nakhonthai/M17AnalogGateway/image/Alinco_Pinout.png

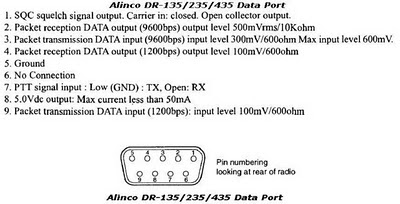
image/Alinco_Pinout.png
