nakhonthai/M17AnalogGateway/image/ESP32DR_Simple_Model.png

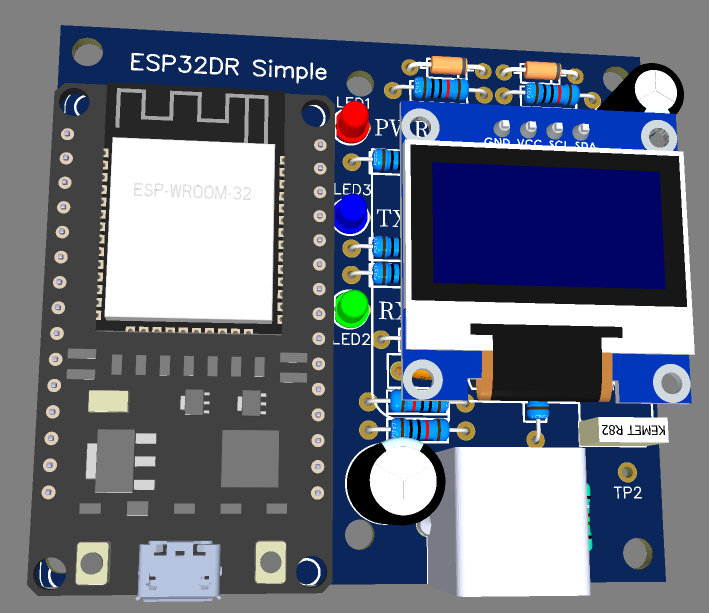
image/ESP32DR_Simple_Model.png
