nakhonthai/M17AnalogGateway/image/PCB_Layout.png

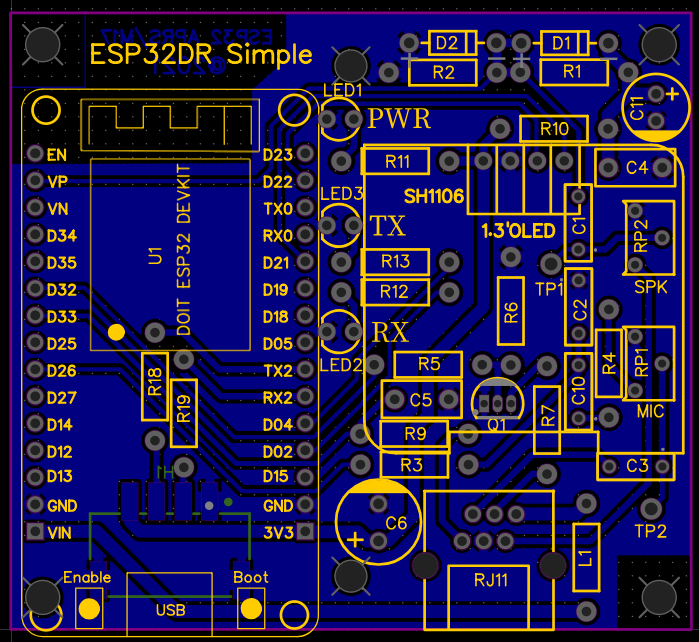
image/PCB_Layout.png
