nakhonthai/M17AnalogGateway/image/RJ12.png

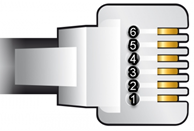
image/RJ12.png
