nakhonthai/M17AnalogGateway/schematic/M17AnalogGw_schematic.png

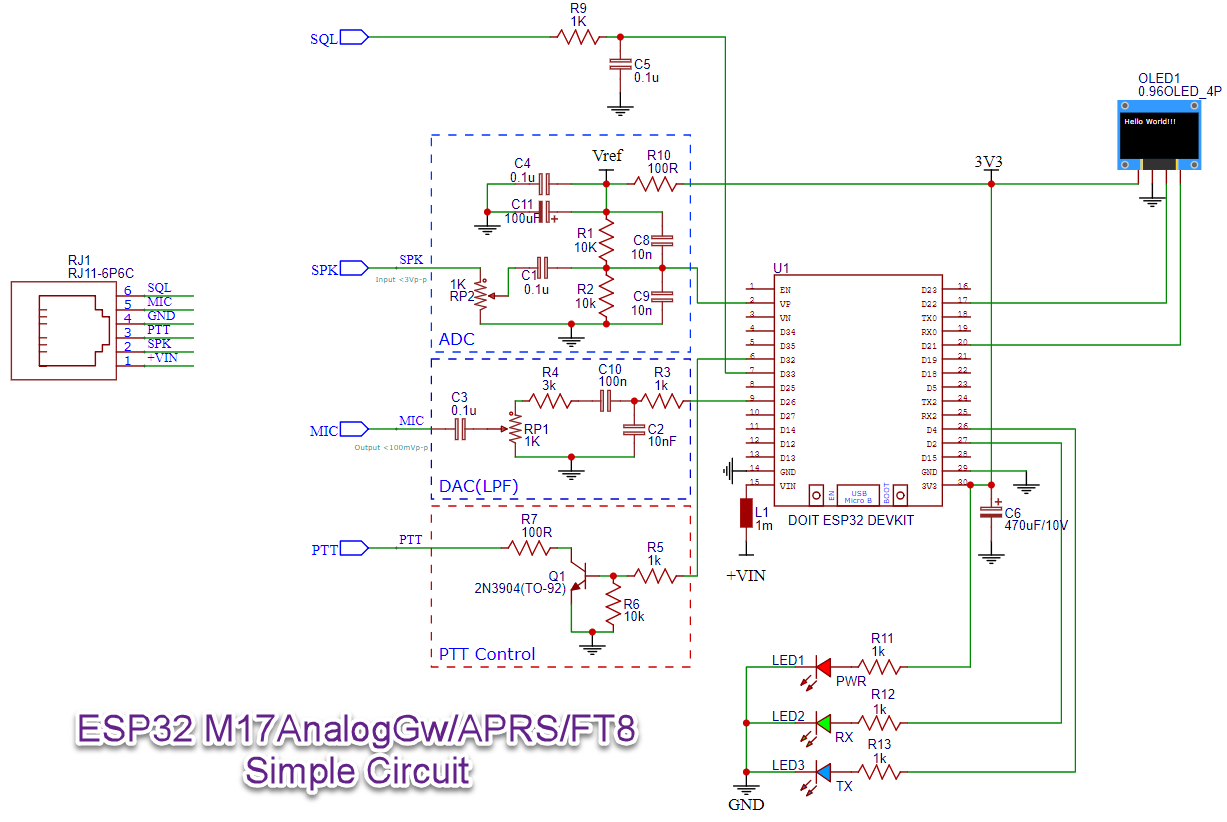
schematic/M17AnalogGw_schematic.png
