nakhonthai/M17AnalogGateway/schematic/M17Hotspot.png

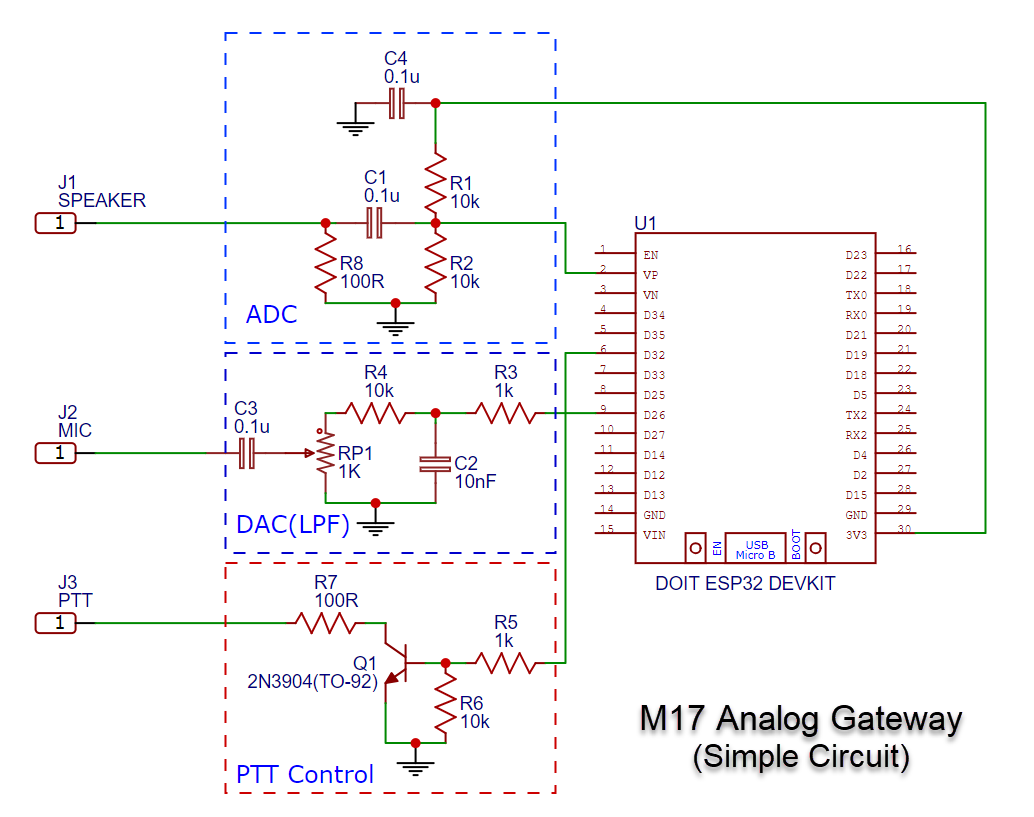
schematic/M17Hotspot.png
