nakhonthai/M17AnalogGateway/(threads)

Thread 5 (2022-03-27):

Add a MEM I2S microphone for the esp32

jumbo5566, 2022-03-27:
i'm trying this SPH0645 MEM microphone
[https://github.com/atomic14/ICS-43434-breakout-board/tree/main/sketch](https://github.com/atomic14/ICS-43434-breakout-board/tree/main/sketch)

nakhonthai, 2022-03-30:
You can connect interface external I2S pinout and change to I2S mode.

Closed 2022-04-05.

Thread 8 (2022-05-11):

Feature request: Analog repeater function

kc1awv, 2022-05-11:
If possible, could the audio path while the ESP32 is receiving also be passed to the TX line with a PTT signal? Basically, operate as an analog repeater, with an analog to digital transcode to an M17 reflector? This could be a simple function with a configuration switch to choose between simplex and duplex.

jumbo5566, 2023-02-19:
YES,the TX LED on just a PTT signal.
on the RF module SRFRS have PTT COS Voice SPK line

Thread 10 (2022-09-23):

Problem with compile version 0.9

sp2ong, 2022-09-23:
Hi,

Can you write which version PlatformIO IDE you are to use in Visual  Studio Code ?

I used latest version PlatformIO IDE v2.5.4 and when I try complied your code form github version 0.9 I have a lot of errors in
code and compile  filed.

src/I2S.cpp:16:14: error: 'RTC_MODULE_TAG' was not declared in this scope
src/I2S.cpp:132:10: error: 'i2s_read_bytes' was not declared in this scope
src/I2S.cpp:137:3: error: 'i2s_write_bytes' was not declared in this scope
src/main.cpp:2285:27: error: cannot convert 'esp_interface_t' to 'wifi_interface_t' in assignment
src/main.cpp:2358:27: error: cannot convert 'esp_interface_t' to 'wifi_interface_t' in assignment
*** [.pio/build/nodemcu-32s/src/I2S.cpp.o] Error 1
*** [.pio/build/nodemcu-32s/src/main.cpp.o] Error 1

sp2ong, 2022-09-23:
When I upload your complied firmware M17AG_ADC_SH1106_V09.bin

rst:0x1 (POWERON_RESET),boot:0x13 (SPI_FAST_FLASH_BOOT)
configsip: 0, SPIWP:0xee
clk_drv:0x00,q_drv:0x00,d_drv:0x00,cs0_drv:0x00,hd_drv:0x00,wp_drv:0x00
mode:DIO, clock div:2
load:0x3fff0018,len:4
load:0x3fff001c,len:1044
load:0x40078000,len:10044
load:0x40080400,len:5900
entry 0x400806ac
v_ref routed to 1.24V

M17 Analog Gateway V0.9
Push BOOT after 3sec for Factory Default config.
Default configure mode!
Default configure!
Create CODEC2_1600 : nsam=320 ,nbit=64 ,nbyte=8
Create CODEC2_3200 : nsam=160 ,nbit=64 ,nbyte=8
Task DSP has been start
Task Network has been start
WiFi Station Only mode.
Current protocol code is 7
Protocol is WIFI_PROTOCOL_11B
Protocol is WIFI_PROTOCOL_11G
Protocol is WIFI_PROTOCOL_11N
WiFi Connecting to APRSTH
..............................Failed. Will retry...

but never I see in my network AP with name "M17AGate" so I can not connect to ESP32

sp2ong, 2022-09-23:
It is look compiled firmware has set up only STATION Mode not have set AP Mode for this reason ESP32 try to connect to APRSTH AP so we need configure own local AP with name APRSTH and passowrd "aprsthnetwork" to allow connect ESP32 and obtain IP adress and after this we can reconfigure ESP32 to own network. It maybe better will be that compiled firmware should be has active AP Mode with name "M17Agate"

jumbo5566, 2023-02-19:
AP mode is don't work, Just Let It RUN Client Mode。

Thread 11 (2023-09-23):

Wi -Fi does not turn on

Guber01, 2023-09-23:
After loading version 0.9 after reset, I clamped the BOOOOT button for 3 seconds. After that, the program started and turned on the display. But Fi Fo does not turn on.

nakhonthai, 2023-10-12:
After upgrade to factory reset by push BOOT button 3s after rx,tx led glow or after power in plug.
You can see wifi AP ssid M17AGate and no password, connect by web browser ip  http://192.168.4.1

Closed 2023-10-12.

Thread 14 (2025-06-15):

VPN

alejandro-atala, 2025-06-15:
Could you please explain the VPN configuration on both the ESP32 board and the WireGuard app? I don't understand what IP address I should enter in each box in both cases.

nakhonthai, 2025-07-04:
You need to have Wireguard VPN service, then enter the client credentials.
