nakhonthai/M17AnalogGateway/doc/ESP32DR_Simple_Schematic.pdf

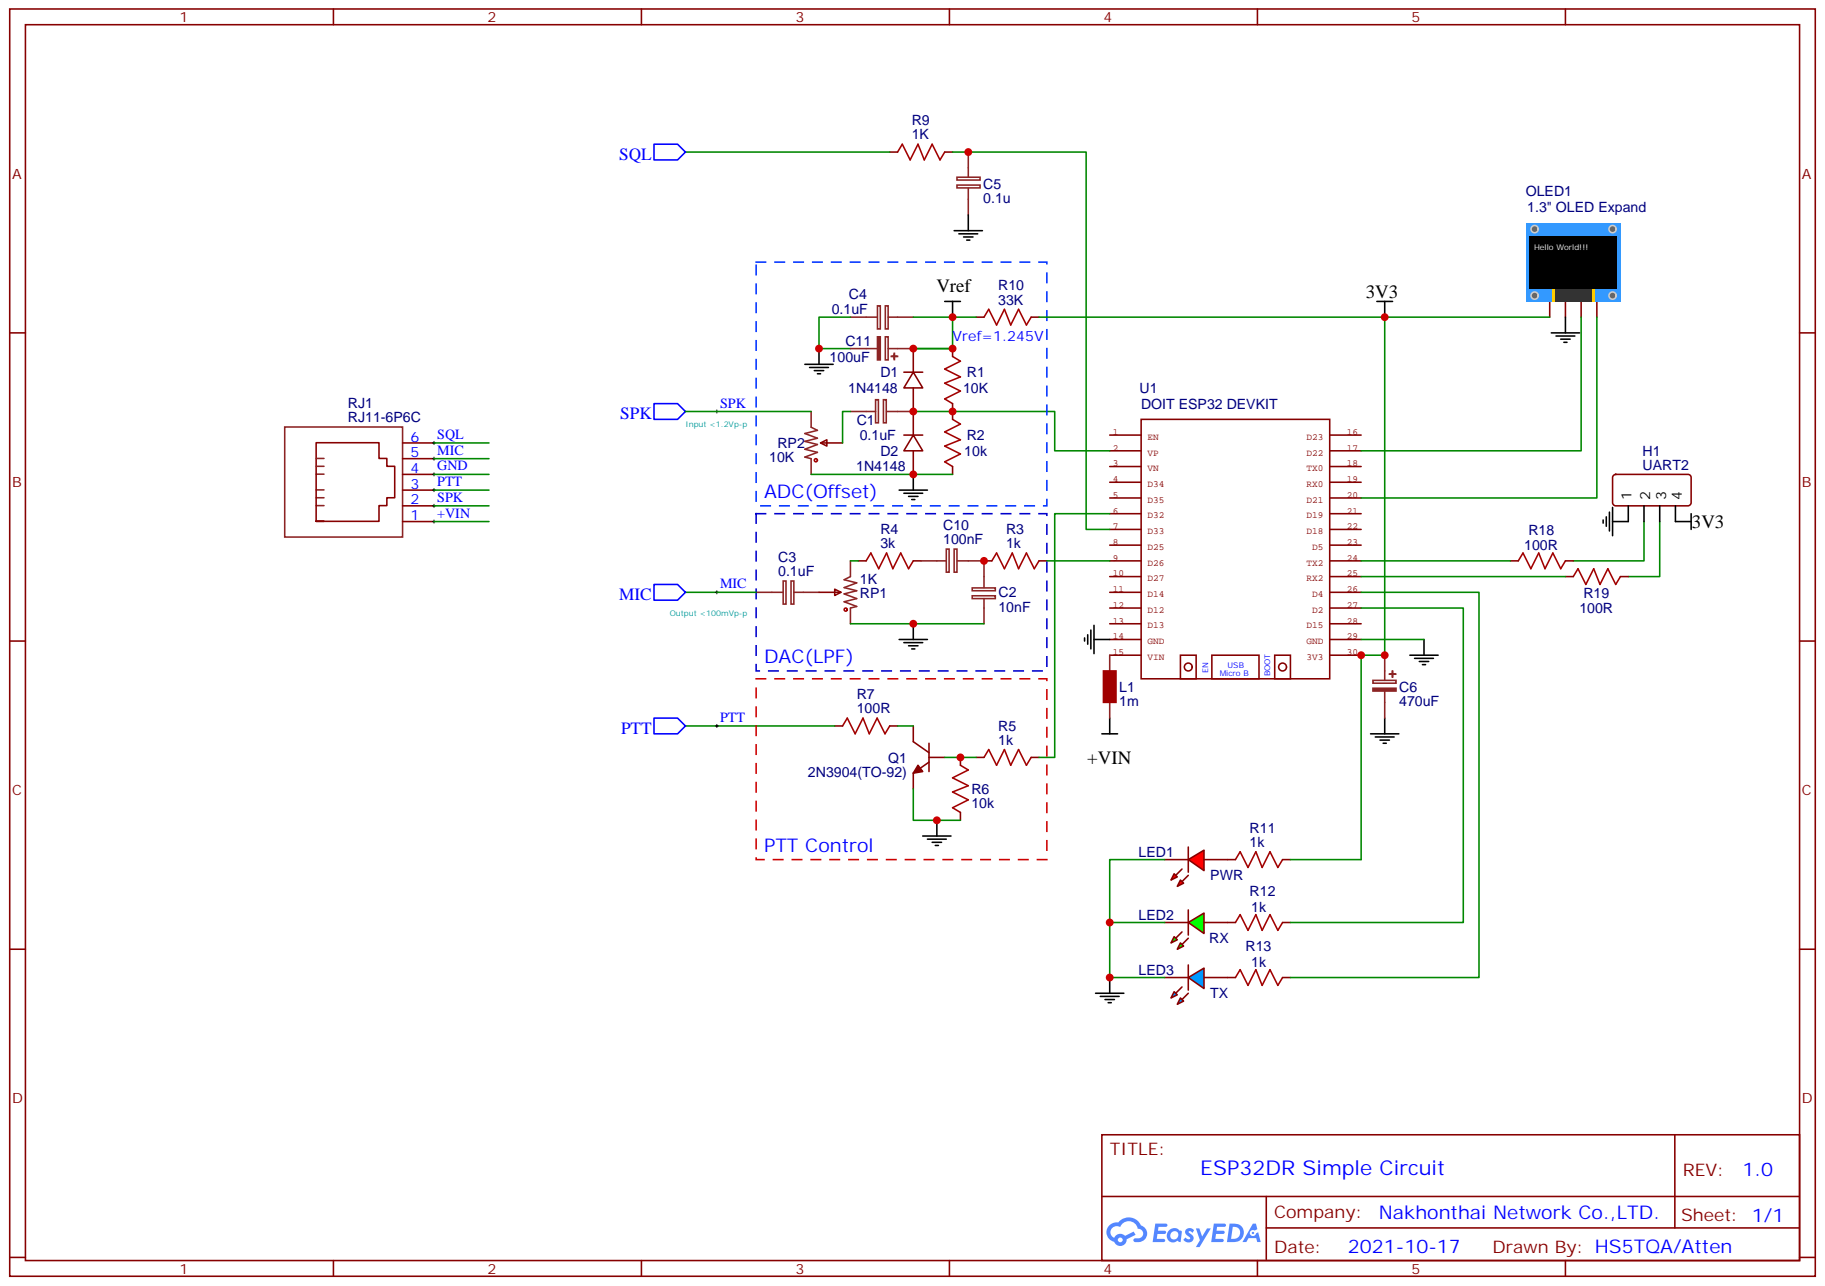
[picture p19: page 1]

Company: Nakhonthai Network Co.,LTD.
