nakhonthai/M17AnalogGateway/schematic/M17AG_schematic.pdf

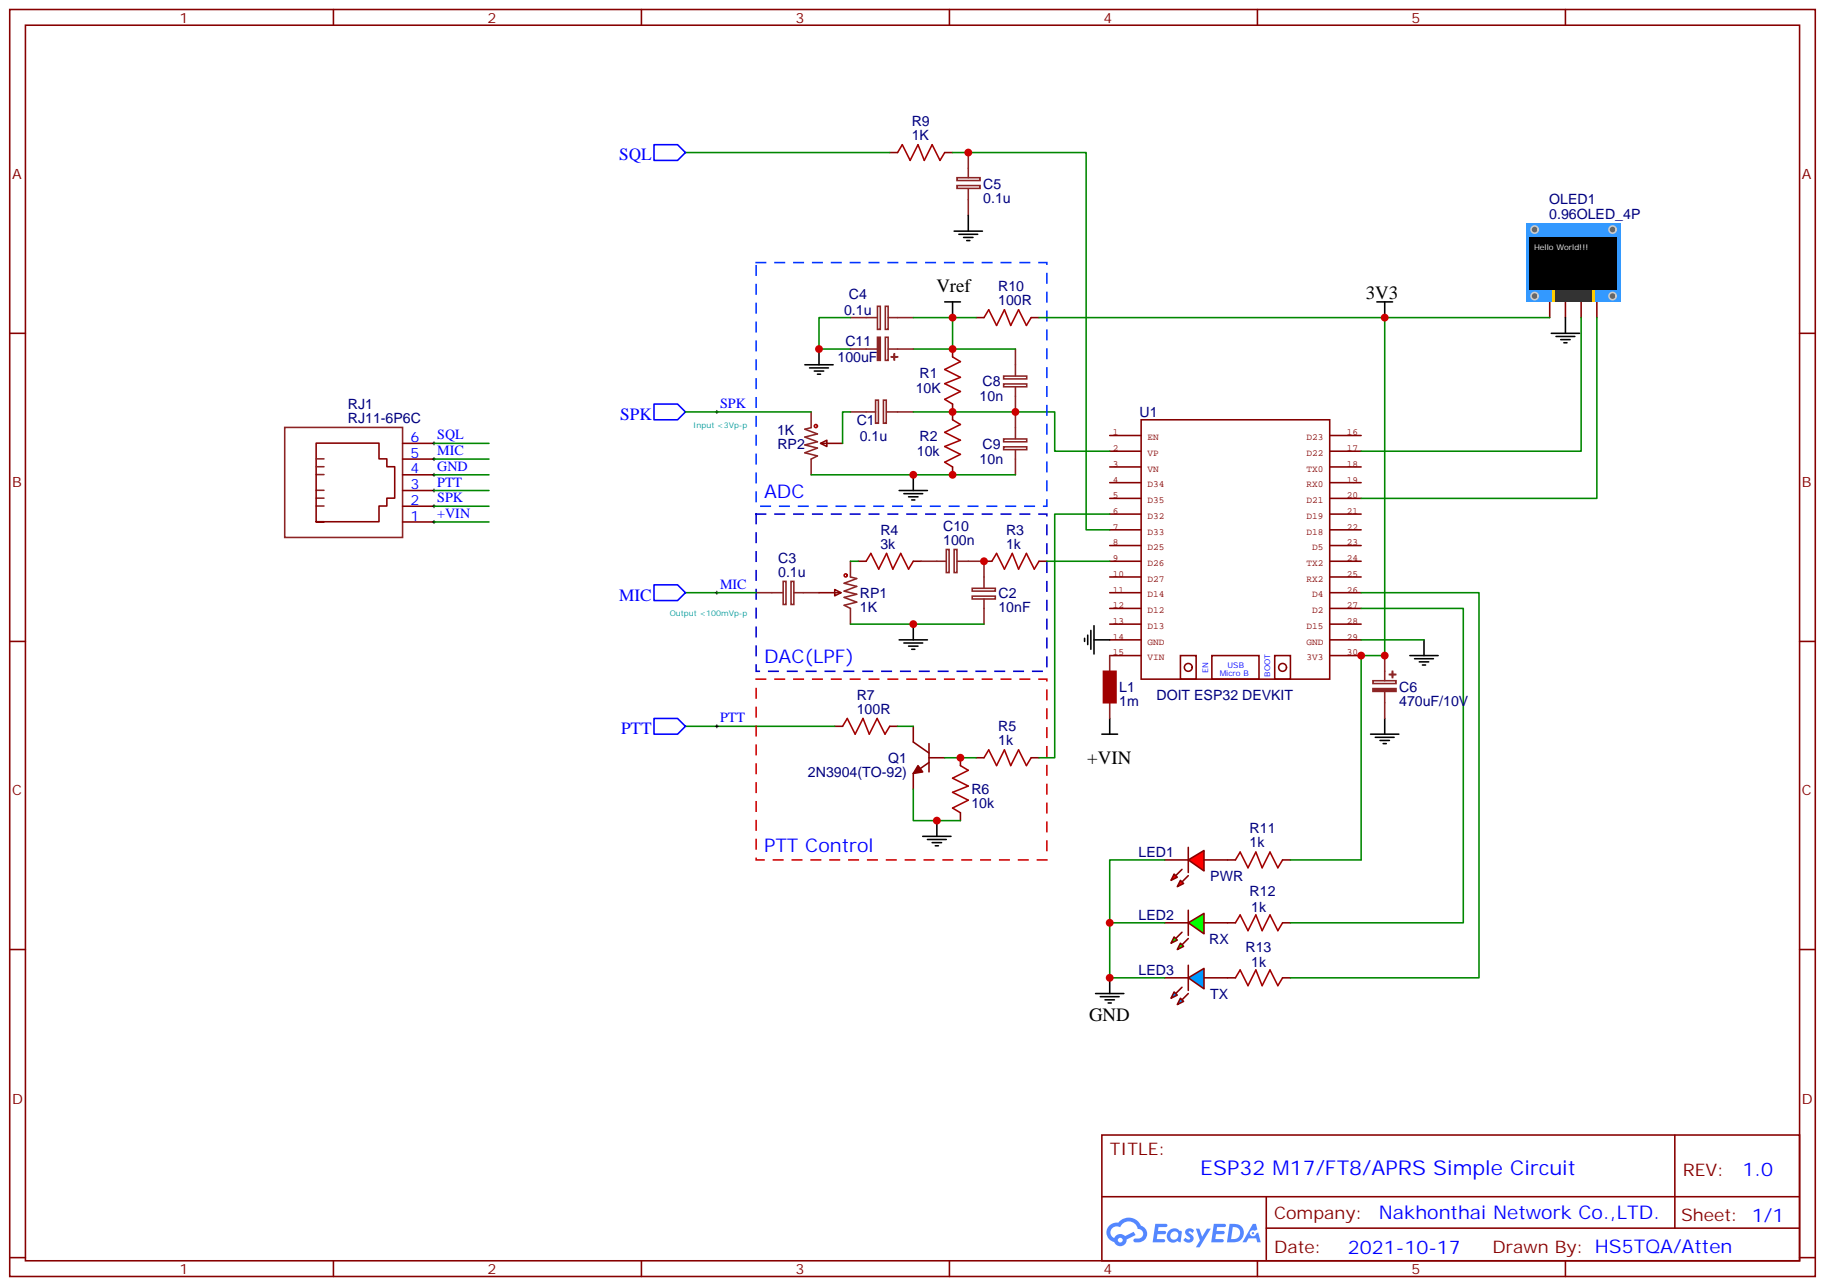
[picture p20: page 1]

Company: Nakhonthai Network Co.,LTD.
