nakhonthai/M17AnalogGateway/include/Voice.h

#ifndef VOICE_H
#define VOICE_H

#include <Arduino.h>
#include "m17.h"

//const unsigned int M17_3200_LENGTH_BYTES = 8U;
//const unsigned char M17_3200_SILENCE[] PROGMEM = {0x01U, 0x00U, 0x09U, 0x43U, 0x9CU, 0xE4U, 0x21U, 0x08U, 0x01U, 0x00U, 0x09U, 0x43U, 0x9CU, 0xE4U, 0x21U, 0x08U};
struct m_m17
{
    char symbol;
    uint16_t start;
    uint8_t length;
};

//0-9,A-Z
//a=alpha,b=bravo,c=charlie,d=delta
//l=linked,n=notlinked,g=linking,y=isbusy
const m_m17 m17voice[] PROGMEM = {{'0', 81, 39}, {'1', 138, 34}, {'2', 194, 22}, {'3', 238, 31}, {'4', 286, 34}, {'5', 337, 46}, {'6', 401, 39}, {'7', 458, 37}, {'8', 513, 29}, {'9', 560, 35}, {'a', 613, 26}, {'b', 661, 34}, {'c', 718, 34}, {'d', 773, 31}, {'A', 825, 19}, {'B', 862, 24}, {'C', 930, 27}, {'D', 1001, 24}, {'E', 1068, 28}, {'F', 1140, 29}, {'G', 1213, 24}, {'H', 1282, 31}, {'I', 1355, 29}, {'J', 1424, 33}, {'K', 1502, 25}, {'L', 1570, 22}, {'M', 1636, 28}, {'N', 1707, 28}, {'O', 1777, 27}, {'P', 1850, 24}, {'Q', 1919, 25}, {'R', 1985, 26}, {'S', 2055, 29}, {'T', 2131, 25}, {'U', 2200, 25}, {'V', 2265, 27}, {'W', 2336, 33}, {'X', 2413, 24}, {'Y', 2481, 26}, {'Z', 2553, 32}, {'l', 2629, 20}, {'n', 2702, 49}, {'g', 2771, 25}, {'y', 2864, 34}};

const uint8_t en_Us[] PROGMEM = {0xCF, 0x80, 0xED, 0xEB, 0x5C, 0xF4, 0x79, 0xE8, 0xCB, 0x00, 0xCF, 0xCB, 0x9E, 0xB7, 0x65, 0x78,
                               0xD8, 0x00, 0xCE, 0xDB, 0x54, 0xFC, 0xAF, 0xCF, 0xC1, 0x00, 0x8C, 0xC2, 0x9E, 0xEC, 0xA5, 0x08,
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
                               0x01, 0x00, 0x09, 0x43, 0x9C, 0xE4, 0x21, 0x08, 0x01, 0x00, 0x09, 0x43, 0x9C, 0xE4, 0x21, 0x08,
                               0x01, 0x00, 0x09, 0x43, 0x9C, 0xE4, 0x21, 0x08, 0x01, 0x00, 0x09, 0x43, 0x9C, 0xE4, 0x21, 0x08,
                               0x01, 0x00, 0x09, 0x43, 0x9C, 0xE4, 0x21, 0x08, 0x72, 0x80, 0x8C, 0x22, 0x5C, 0xA7, 0xE5, 0x2C,
                               0xC0, 0x00, 0xED, 0x42, 0xDC, 0xE5, 0xE5, 0x6E, 0xD6, 0x00, 0xEC, 0xC2, 0xDE, 0xE4, 0xAF, 0x39,
                               0xD0, 0x00, 0xC5, 0xD2, 0x94, 0xE7, 0x69, 0xDB, 0xCF, 0x00, 0x84, 0xD3, 0xDE, 0x97, 0x2F, 0x18,
                               0xD2, 0x00, 0xC7, 0xF2, 0x94, 0xF4, 0x3B, 0x69, 0xD8, 0x80, 0x4D, 0xC2, 0x54, 0xD4, 0x25, 0xFE,
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

void linkedTo(char *reflector);
void createVoice(char *text);

#endif
