nakhonthai/M17AnalogGateway/(commit log)

2021-10-17 Add simple schematic
2021-10-17 Change url schematic picture
2021-11-04 Add SQL Signal and edit bug ADC ISR.
2021-11-04 Add SQL Signal and edit bug ADC ISR
    [m17.cpp, main.cpp, main.h]
2021-11-04 Default ADC v_ref routed to 3.3V
2021-11-04 Upload new schematic
